LenShustek/Wolf_oven_temperature_controller/testers/oven_mockup.jpg

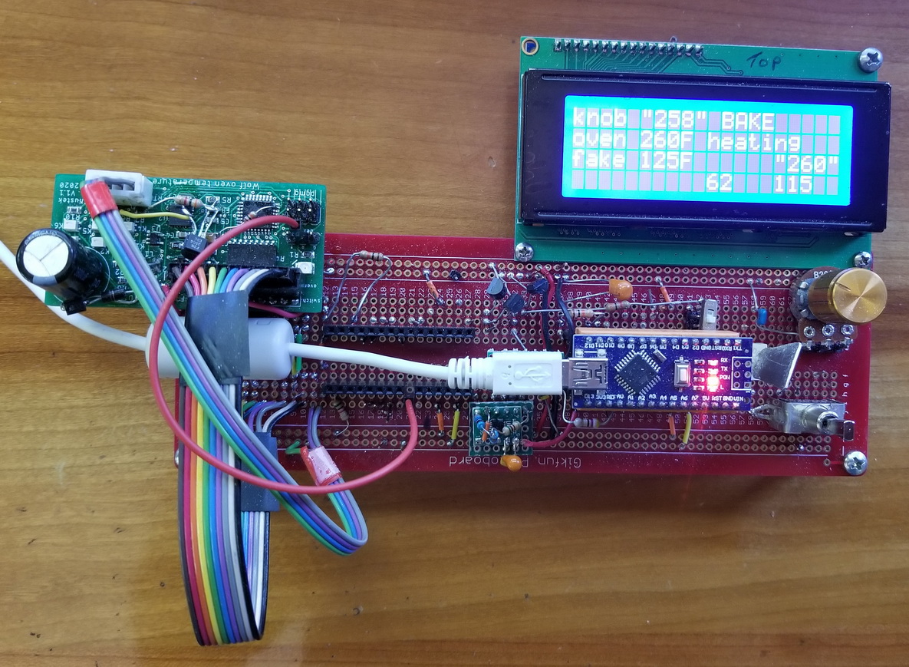
testers/oven_mockup.jpg
