LenShustek/Wolf_oven_temperature_controller/photos/knob_display_signal.jpg

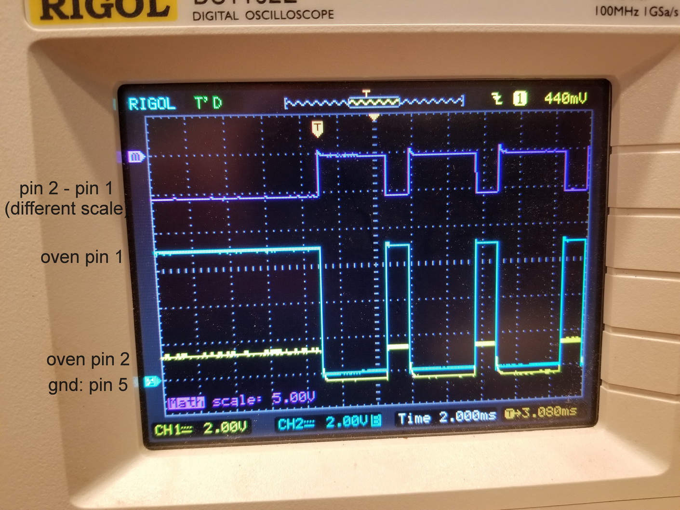
photos/knob_display_signal.jpg
