LenShustek/Wolf_oven_temperature_controller/photos/knob_back.jpg

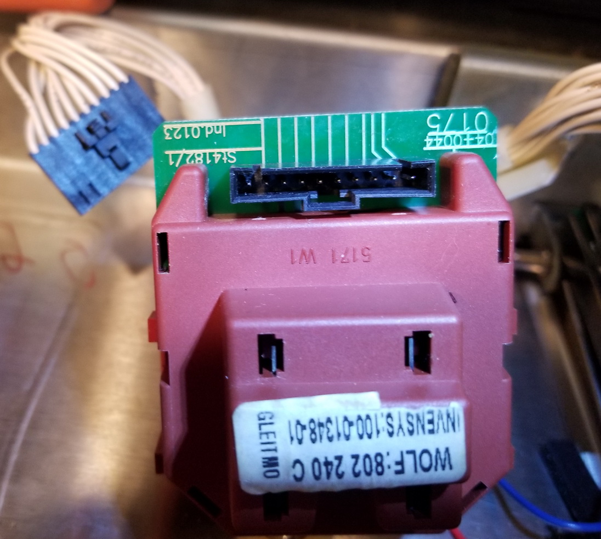
photos/knob_back.jpg
