LenShustek/Wolf_oven_temperature_controller/photos/knob_inside.jpg

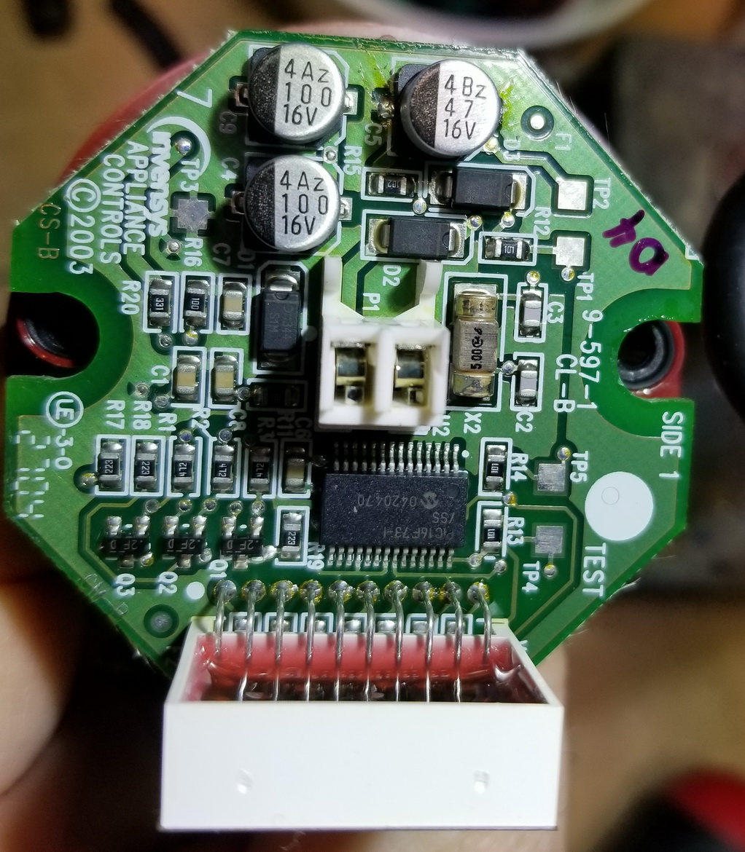
photos/knob_inside.jpg
