LenShustek/Wolf_oven_temperature_controller/photos/PC_boards.jpg

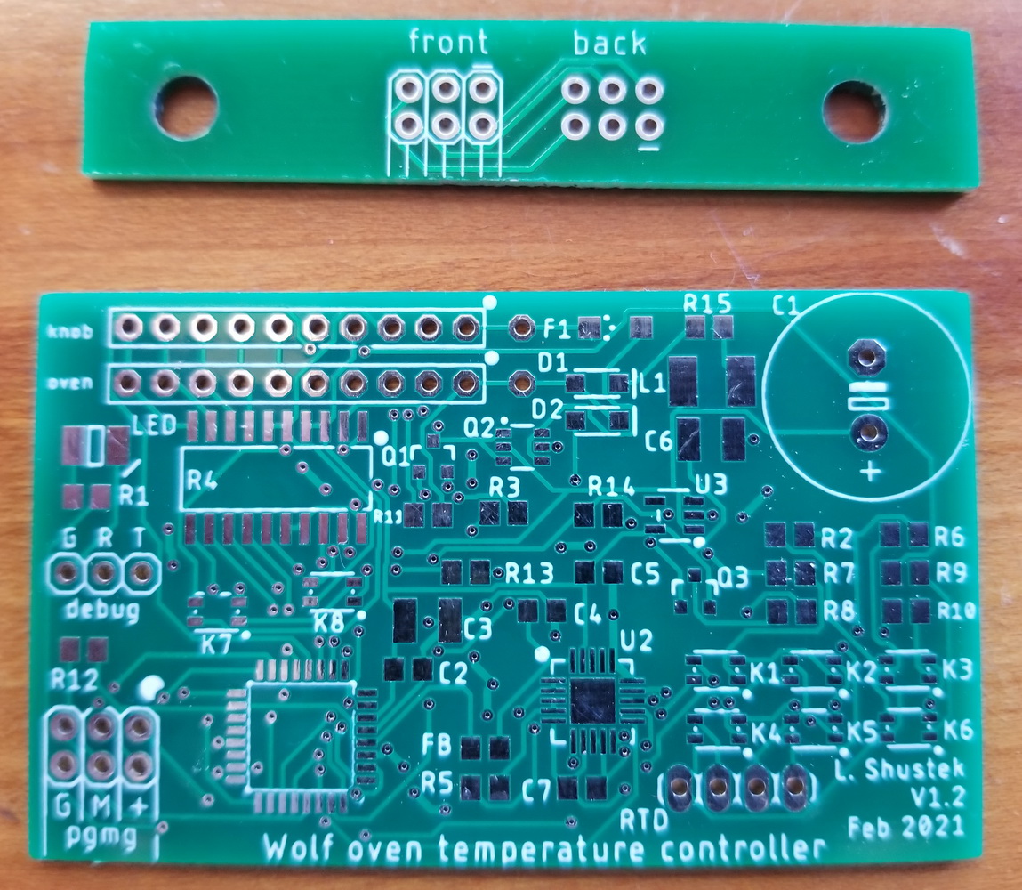
photos/PC_boards.jpg
