LenShustek/Wolf_oven_temperature_controller/testers/run_2021_03_14.xlsx

secs | temp | heating
0 | 249 | 0
10 | 249 | 50
20 | 251 | 100
30 | 253 | 100
40 | 256 | 100
50 | 260 | 100
60 | 262 | 100
70 | 264 | 100
80 | 268 | 100
90 | 269 | 100
100 | 272 | 100
110 | 274 | 100
120 | 277 | 100
130 | 279 | 100
140 | 283 | 100
150 | 286 | 100
160 | 288 | 100
170 | 291 | 100
180 | 293 | 100
190 | 295 | 100
200 | 298 | 100
210 | 299 | 100
220 | 302 | 100
230 | 304 | 100
240 | 308 | 100
250 | 310 | 100
260 | 313 | 100
270 | 315 | 100
280 | 317 | 50
290 | 319 | 50
300 | 320 | 100
310 | 321 | 100
320 | 322 | 100
330 | 323 | 100
340 | 325 | 100
350 | 326 | 100
360 | 326 | 100
370 | 327 | 100
380 | 329 | 100
390 | 330 | 100
400 | 331 | 100
410 | 332 | 100
420 | 334 | 100
430 | 334 | 100
440 | 335 | 100
450 | 336 | 100
460 | 338 | 100
470 | 340 | 100
480 | 340 | 100
490 | 342 | 100
500 | 342 | 100
510 | 344 | 100
520 | 345 | 100
530 | 346 | 100
540 | 348 | 100
550 | 348 | 100
560 | 349 | 100
570 | 351 | 100
580 | 352 | 100
590 | 354 | 100
600 | 355 | 100
610 | 355 | 50
620 | 355 | 0
630 | 355 | 0
640 | 355 | 0
650 | 354 | 0
660 | 354 | 0
670 | 354 | 0
680 | 354 | 0
690 | 352 | 0
700 | 352 | 0
710 | 352 | 0
720 | 352 | 0
730 | 352 | 0
740 | 352 | 0
750 | 352 | 0
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
