LenShustek/Wolf_oven_temperature_controller/testers/Wolf_oven_mockup.pdf

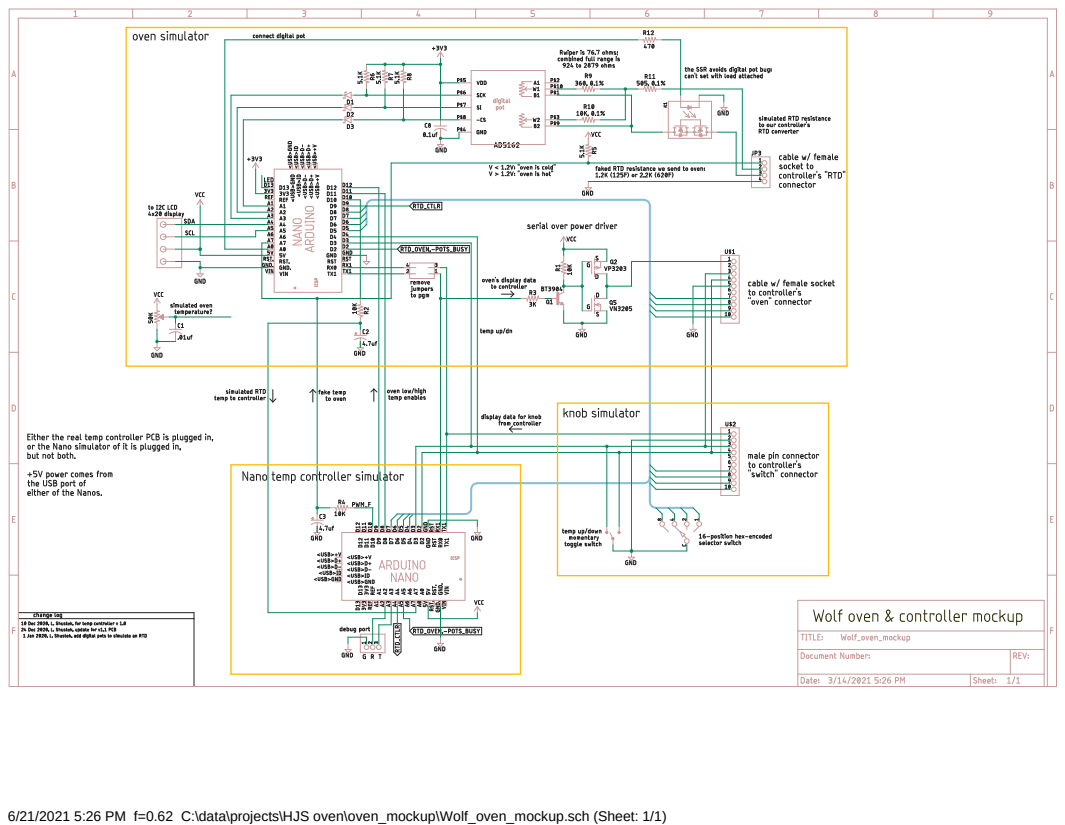
[picture p6: page 1]

6/21/2021 5:26 PM f=0.62 C:\data\projects\HJS oven\oven_mockup\Wolf_oven_mockup.sch (Sheet: 1/1)
