LenShustek/Wolf_oven_temperature_controller/Wolf_temp_controller_v1.2_brd.pdf

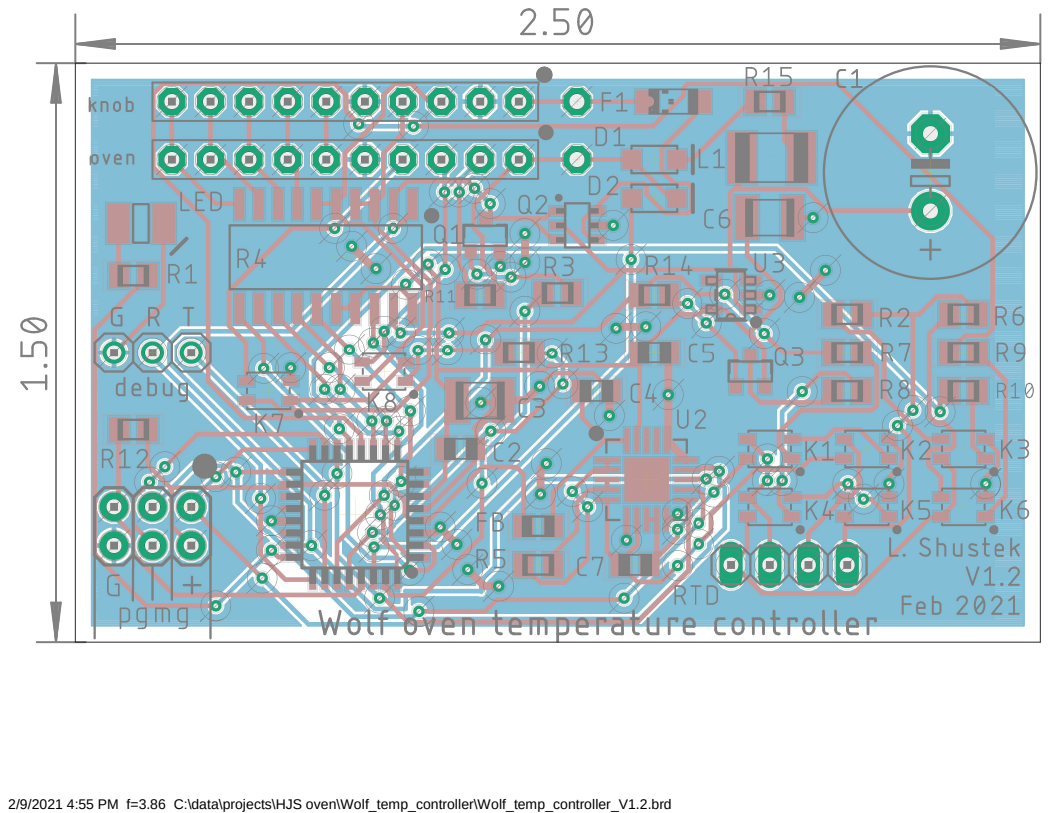
[picture p7: page 1]

2/9/2021 4:55 PM f=3.86 C:\data\projects\HJS oven\Wolf_temp_controller\Wolf_temp_controller_V1.2.brd
