LenShustek/Wolf_oven_temperature_controller/Wolf_temp_controller_v1.2_sch.pdf

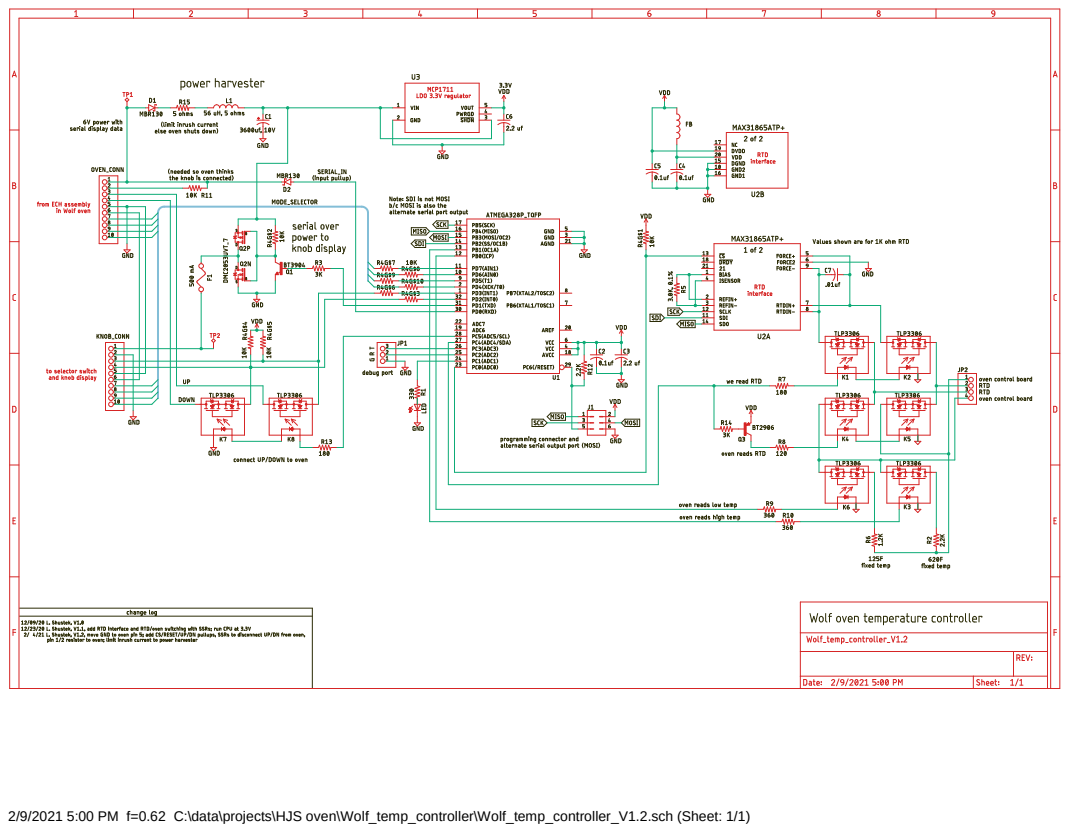
[picture p8: page 1]

2/9/2021 5:00 PM f=0.62 C:\data\projects\HJS oven\Wolf_temp_controller\Wolf_temp_controller_V1.2.sch (Sheet: 1/1)
